abhijay-py/custom-keypad/KiCAD Files/3D Models/asm_mx_asm_PCB.stp

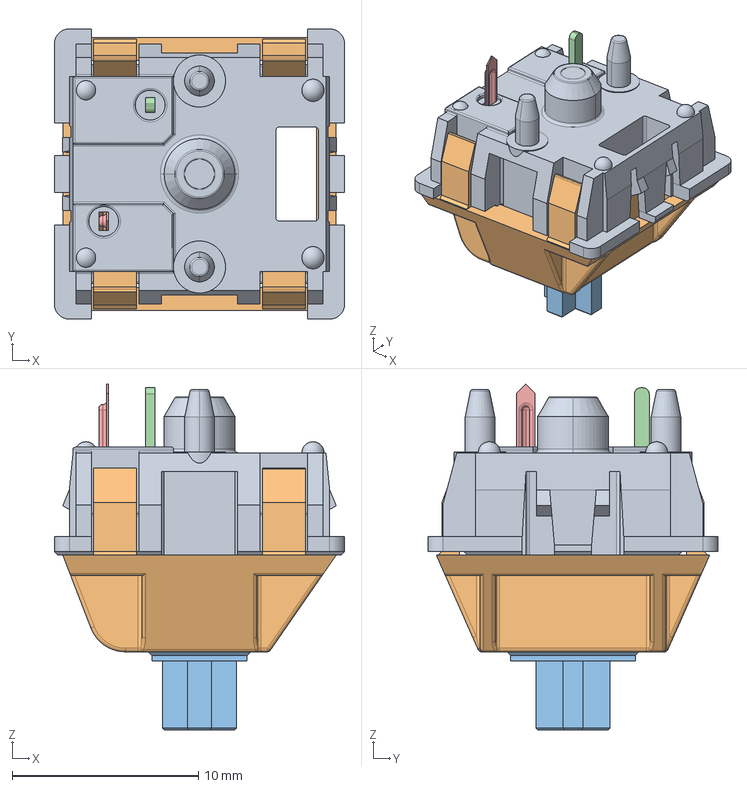
[picture p2: CAD file, 2025-04-11]
KiCAD Files/3D Models/asm_mx_asm_PCB.stp
15.6 x 15.6 x 18.6 mm
MX_DOWN
MX_UP
UP_MX
MX_PIN
MX_SPRING
MX_CLICK
