abhijay-py/custom-keypad/KiCAD Files/3D Models/EN11-HSM1BF20.stp

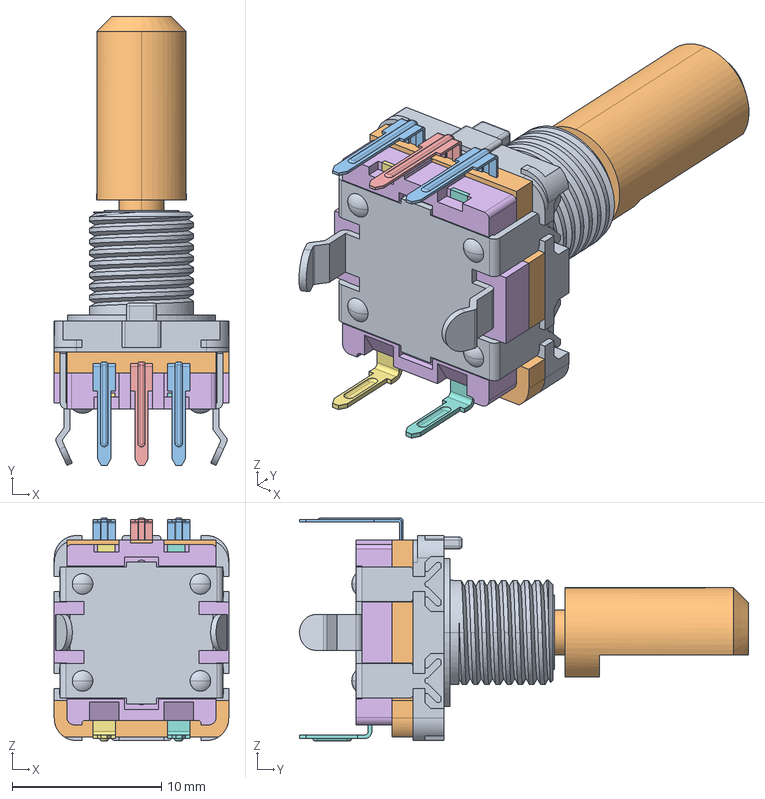
[picture p3: CAD file, 2025-04-14]
KiCAD Files/3D Models/EN11-HSM1BF20.stp
11.7 x 30.1 x 14.9 mm
