abhijay-py/custom-keypad/KiCAD Files/custom-keypad.step

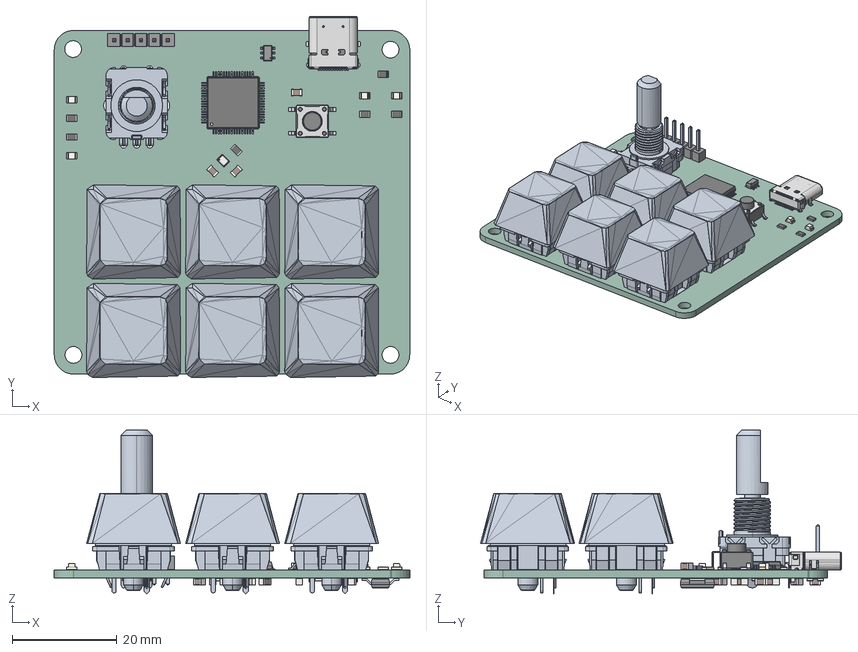
[picture p4: CAD file, 2025-07-17]
KiCAD Files/custom-keypad.step
67.8 x 68.9 x 31.3 mm
LED_0805_2012Metric x 4
R_0805_2012Metric x 10
ASM_MX_ASM x 6
product0 x 6
ASSEMBLY x 3
C_0805_2012Metric x 18
222AMVBAR
logo
dot
pins
F11ES7H20M_ASM
LQFP_64_10x10mm_P05mm
UJ32-C-H-G-H2-SMT-TR
custom-keypad_PCB
