abhijay-py/custom-keypad/Mechanical Case Files/case_bottom.stl

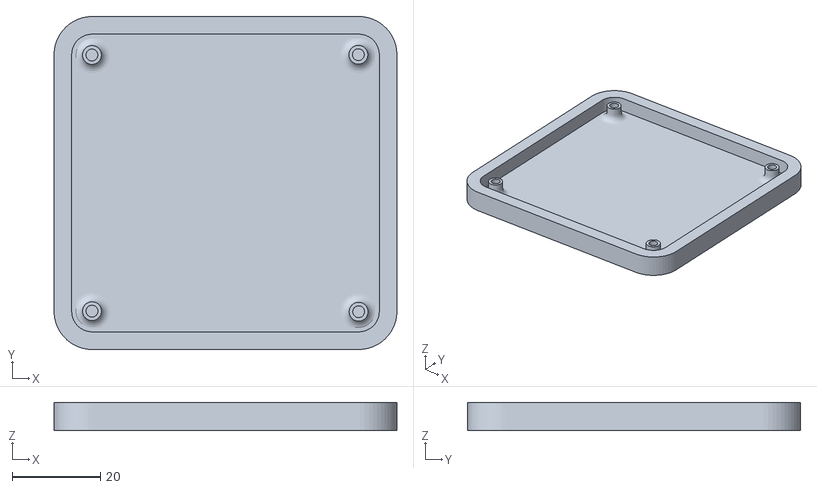
[picture p5: CAD file, 2025-07-17]
Mechanical Case Files/case_bottom.stl
77.8 x 75.6 x 6.40
