abhijay-py/custom-keypad/KiCAD Files/3D Models/XRCGB25M000FAN00R0.stp

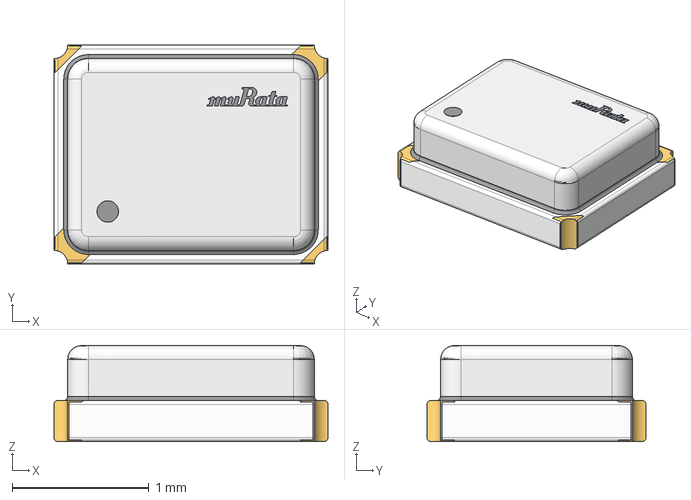
[picture p6: CAD file, 2025-04-12]
KiCAD Files/3D Models/XRCGB25M000FAN00R0.stp
2.00 x 1.60 x 0.702 mm
