abhijay-py/custom-keypad/Mechanical Case Files/case_top.stl

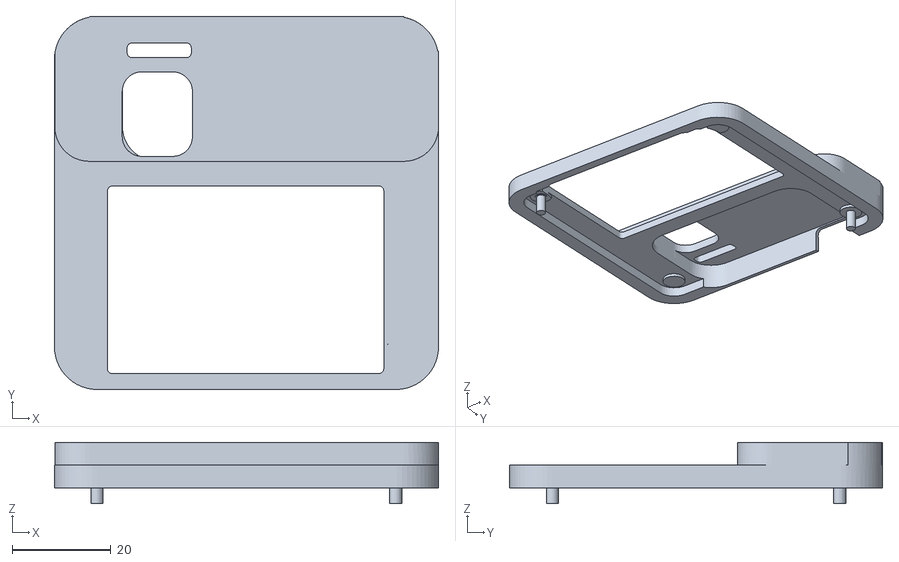
[picture p7: CAD file, 2025-07-17]
Mechanical Case Files/case_top.stl
77.8 x 75.6 x 12.5
