abhijay-py/custom-keypad/KiCAD Files/3D Models/ImageToStl.com_Simple-CherryMX-Keycap.stp

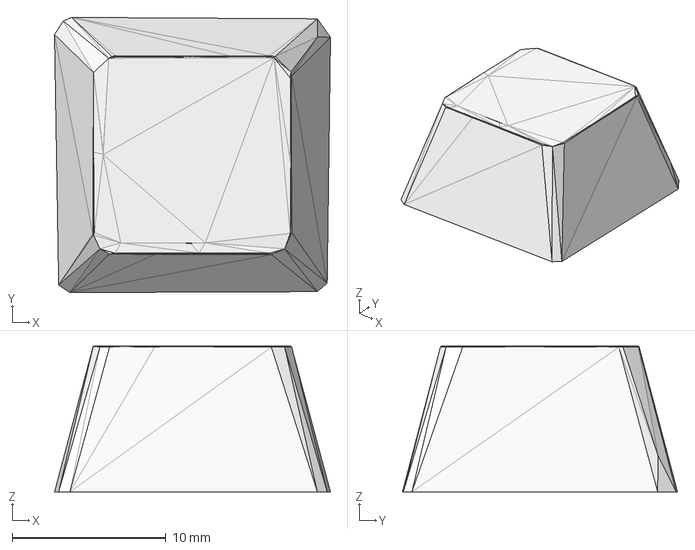
[picture p8: CAD file, 2025-04-11]
KiCAD Files/3D Models/ImageToStl.com_Simple-CherryMX-Keycap.stp
18.0 x 17.9 x 9.50 mm
