abhijay-py/custom-keypad/KiCAD Files/3D Models/UJ32-C-H-G-H2-SMT-TR.stp

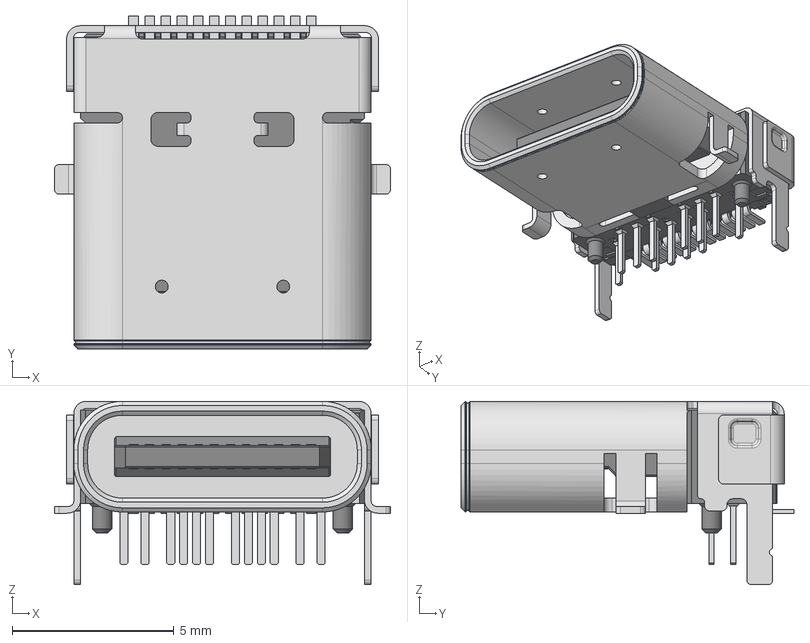
[picture p9: CAD file, 2025-04-11]
KiCAD Files/3D Models/UJ32-C-H-G-H2-SMT-TR.stp
10.4 x 10.3 x 5.67 mm
