abhijay-py/custom-keypad/KiCAD Files/3D Models/USBLC6-2SC6.stp

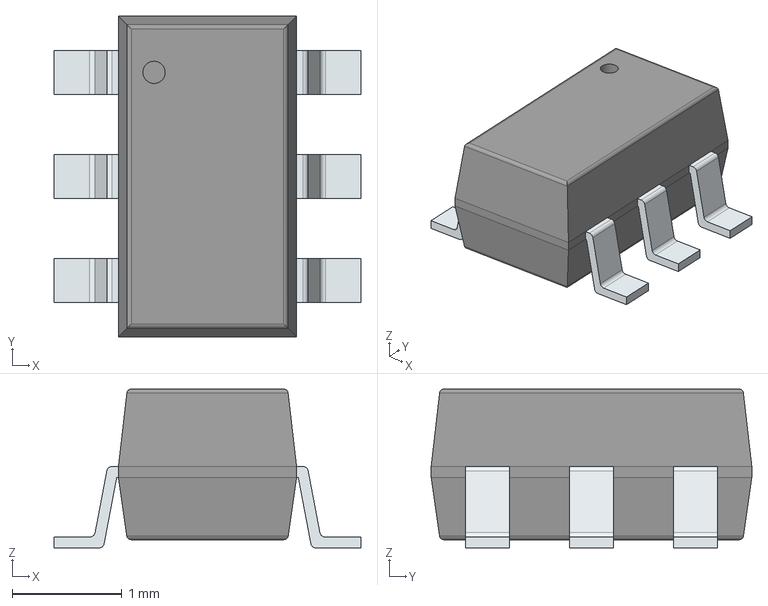
[picture p10: CAD file, 2025-04-11]
KiCAD Files/3D Models/USBLC6-2SC6.stp
2.80 x 2.92 x 1.45 mm
PinsArrayLR
