abhijay-py/custom-keypad/KiCAD Files/3D Models/LFXTAL010595.stp

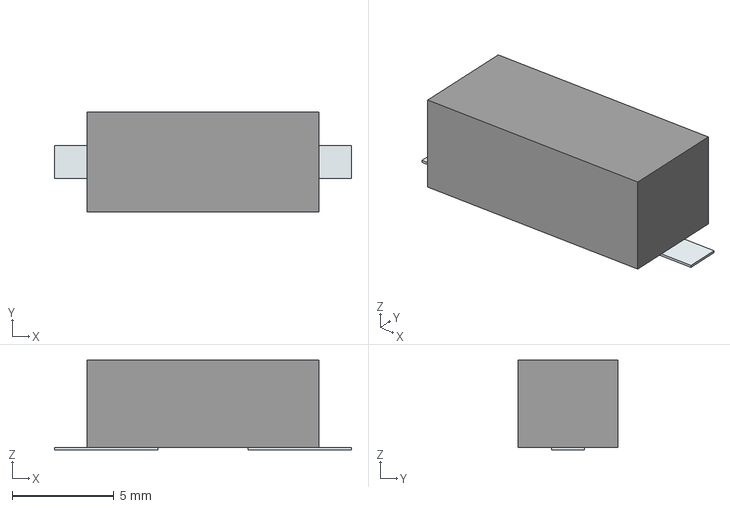
[picture p11: CAD file, 2025-04-11]
KiCAD Files/3D Models/LFXTAL010595.stp
14.6 x 4.90 x 4.40 mm
Pins
