abhijay-py/custom-keypad/KiCAD Files/3D Models/222AMVBAR.stp

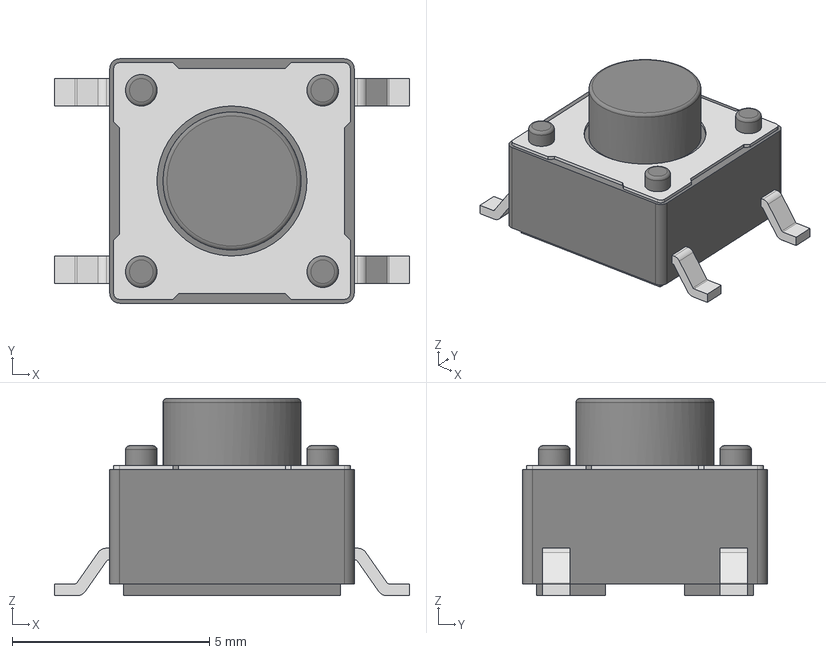
[picture p12: CAD file, 2025-04-11]
KiCAD Files/3D Models/222AMVBAR.stp
9.00 x 6.20 x 5.00 mm
