abhijay-py/custom-keypad/KiCAD Files/3D Models/AZ1117IH-3.3TRG1.stp

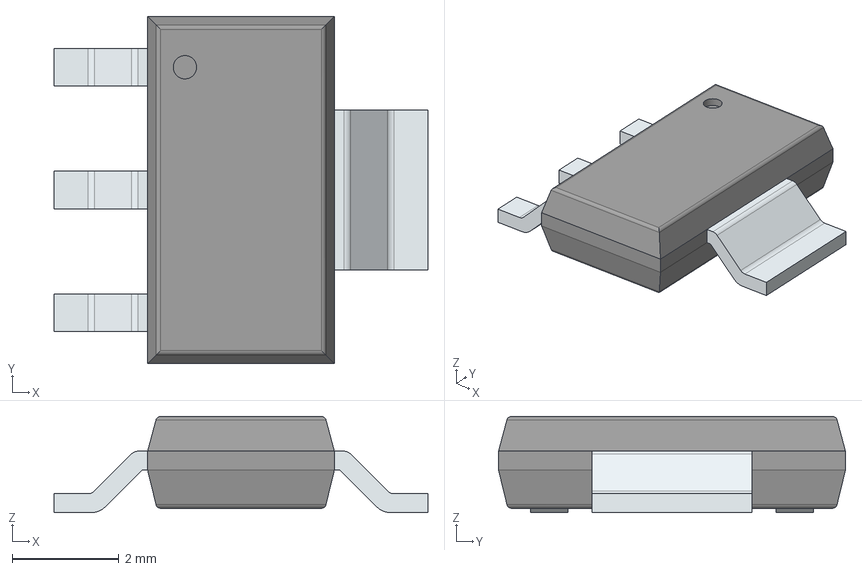
[picture p13: CAD file, 2025-04-11]
KiCAD Files/3D Models/AZ1117IH-3.3TRG1.stp
7.00 x 6.50 x 1.80 mm
PinsArrayL
FilletPinR
