abhijay-py/custom-keypad/KiCAD Files/3D Models/61300511121.stp

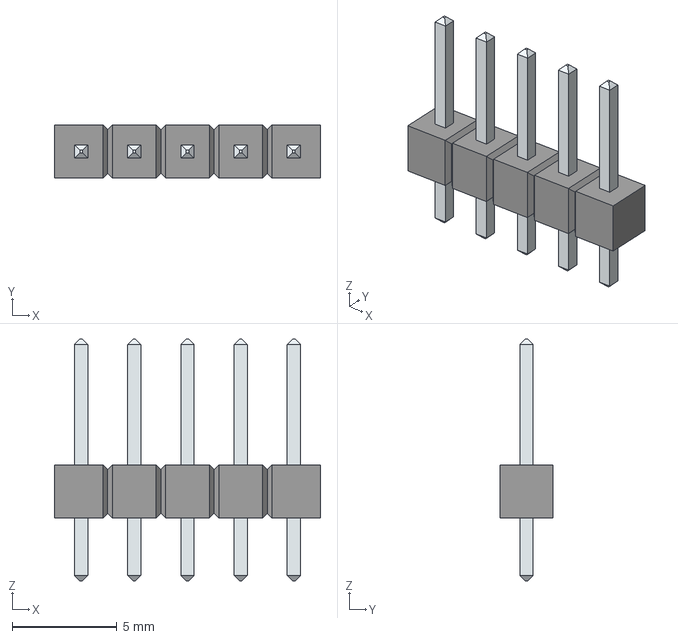
[picture p14: CAD file, 2025-04-11]
KiCAD Files/3D Models/61300511121.stp
12.7 x 2.54 x 11.5 mm
LeadsArray
