abhijay-py/custom-keypad/KiCAD Files/custom-keypad.kicad_pcb

## KiCad design KiCAD Files/custom-keypad.kicad_pcb (2025-04-23)

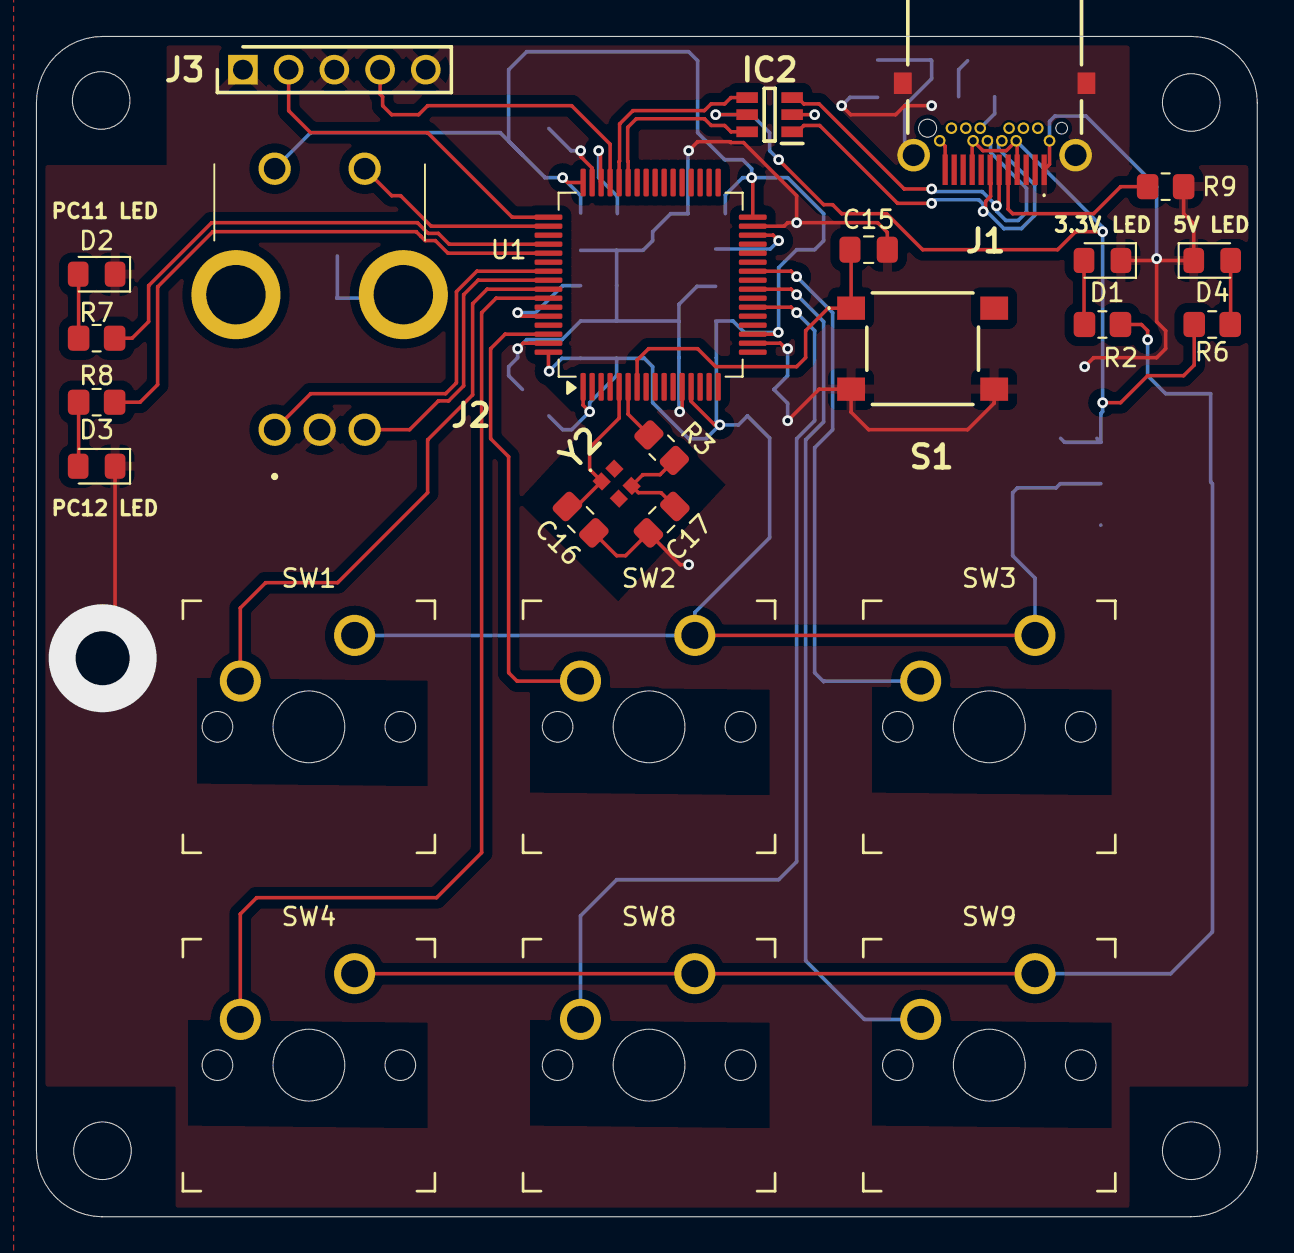
[picture p15: board custom-keypad.kicad_pcb from above]

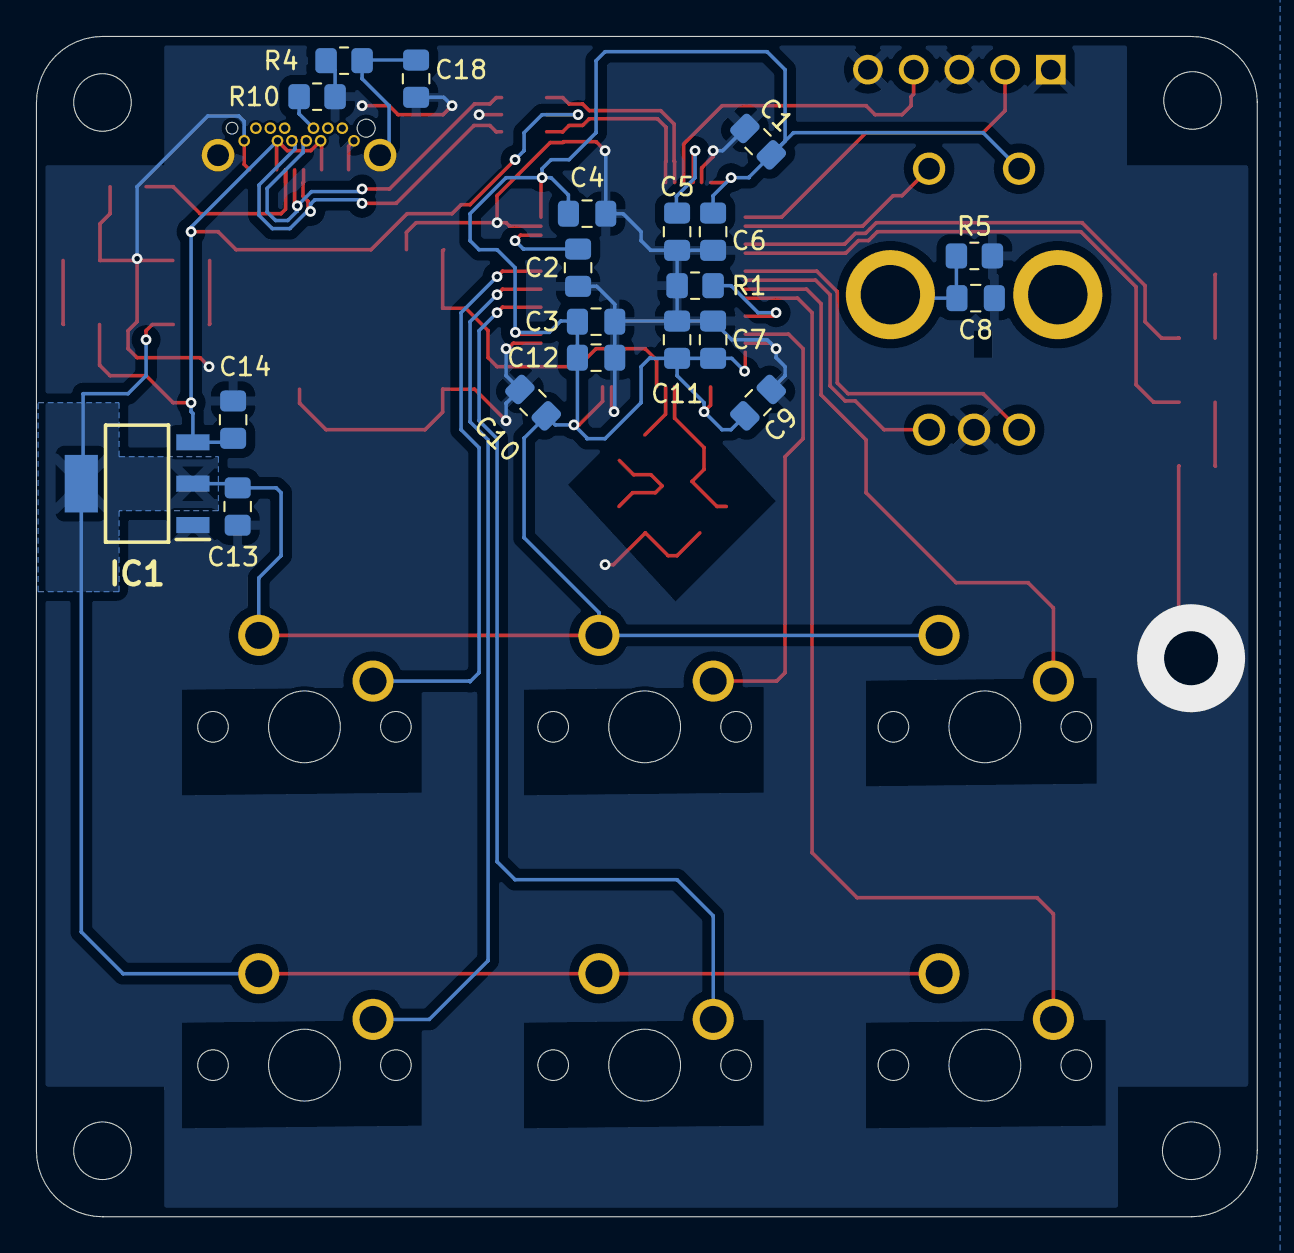
[picture p16: board custom-keypad.kicad_pcb from below]

Board: 2 copper layers, 67.8 x 65.6 mm, 46 parts (20 on the bottom side), 35 nets.

Parts:
C1: 4.7u; C_0805_2012Metric_Pad1.18x1.45mm_HandSolder
C2, C3, C4, C5, C6, C7, C11, C12: 100n; C_0805_2012Metric_Pad1.18x1.45mm_HandSolder
C8, C18: 2.2n; C_0805_2012Metric_Pad1.18x1.45mm_HandSolder
C9, C10: 1u; C_0805_2012Metric_Pad1.18x1.45mm_HandSolder
C13: 22u; C_0805_2012Metric_Pad1.18x1.45mm_HandSolder
C14: 10u; C_0805_2012Metric_Pad1.18x1.45mm_HandSolder
C15: 0.1u; C_0805_2012Metric_Pad1.18x1.45mm_HandSolder
C16, C17: 10p; C_0805_2012Metric_Pad1.18x1.45mm_HandSolder
D1, D2, D3, D4: LED; LED_0805_2012Metric_Pad1.15x1.40mm_HandSolder
IC1: AZ1117IH-3.3TRG1; SOT230P700X180-4N
IC2: USBLC6-2SC6; SOT95P280X145-6N
J1: UJ32-C-H-G-H2-SMT-TR; UJ32CHGH2SMTTR
J2: EN11-HSM1BF20; EN11HSM1BF20
J3: 61300511121; HDRV5W64P0X254_1X5_1270X254X854P
R1: 10k; R_0805_2012Metric_Pad1.20x1.40mm_HandSolder
R2, R7, R8: 220; R_0805_2012Metric_Pad1.20x1.40mm_HandSolder
R3, R6: 330; R_0805_2012Metric_Pad1.20x1.40mm_HandSolder
R4, R5: 1M; R_0805_2012Metric_Pad1.20x1.40mm_HandSolder
R9, R10: 5.1k; R_0805_2012Metric_Pad1.20x1.40mm_HandSolder
S1: 222AMVBAR
SW1, SW2, SW3, SW4, SW8, SW9: SW_Push; SW_MX
U1: STM32H7A3RGTx; LQFP-64_10x10mm_P0.5mm
Y2: XRCGB25M000FAN00R0; XRCGB

Connections:
+5V: C14.1, IC1.3 (INPUT), IC2.5 (VBUS), J1.A4 (VBUS_1), J1.A9 (VBUS_2), J1.B4 (VBUS_3), J1.B9 (VBUS_4), R6.1
D+: IC2.3 (I/O2_1), J1.A6 (DP1), J1.B6 (DP2)
D-: IC2.1 (I/O1_1), J1.A7 (DN1), J1.B7 (DN2)
GND: C1.2, C2.2, C3.2, C4.2, C5.2, C6.2, C7.2, C8.2, C9.2, C10.2, C11.2, C12.2, C13.2, C14.2, C15.2, C16.2, C17.2, C18.2, D1.1 (K), D2.1 (K), D3.1 (K), D4.1 (K), IC1.1 (ADJ/GND), IC2.2 (GND), J1.A1 (GND_1), J1.A12 (GND_2), J1.B1 (GND_3), J1.B12 (GND_4), J2.C1, J3.1, J3.3, J3.5, R1.2, R4.2, R5.2, R9.2, R10.2, S1.2 (NO_1), S1.4 (NO_2), U1.12 (VSSA), U1.18 (VSS), U1.31 (VSS), U1.47 (VSS), U1.63 (VSS)
unnamed: C8.1, J2.MH2, R5.1
unnamed: C18.1, J1.MH2, R4.1
unnamed: D1.2 (A), R2.2
unnamed: D2.2 (A), R7.2
unnamed: D3.2 (A), R8.2
unnamed: D4.2 (A), R6.2
unnamed: J1.A5 (CC1), R9.1
unnamed: J1.B5 (CC2), R10.1
unnamed: R1.1, U1.60 (BOOT0)
unnamed: C17.1, R3.1, Y2.3 (XTAL_2)
PA6/Key 5: SW8.2, U1.22 (PA6)
PA13/SWDIO: J3.4, U1.45 (PA13)
PA14/SWCLK: J3.2, U1.49 (PA14)
PA15/Rotary SW: J2.E1, U1.50 (PA15)
PB0/Key 3: SW3.2, U1.26 (PB0)
PB3/Rotary A: J2.A1, U1.55 (PB3)
PB4/Rotary B: J2.B1, U1.56 (PB4)
PB5/Key 1: SW1.2, U1.57 (PB5)
PB6/Key 4: SW4.2, U1.58 (PB6)
PB9/Key 2: SW2.2, U1.62 (PB9)
PC4/Key 6: SW9.2, U1.24 (PC4)
PC11/Debug PC11: R7.1, U1.52 (PC11)
PC12/Debug PC12: R8.1, U1.53 (PC12)
PH0/OSC IN: C16.1, U1.5 (PH0), Y2.1 (XTAL_1)
PH1/OSC OUT: R3.2, U1.6 (PH1)
USB+: IC2.4 (I/O2_2), U1.44 (PA12)
USB-: IC2.6 (I/O1_2), U1.43 (PA11)
VBAT: C1.1, C3.1, C4.1, C6.1, C7.1, C9.1, C10.1, C11.1, C12.1, C13.1, IC1.2 (OUTPUT), IC1.4 (VOUT), J2.D1, R2.1, SW1.1, SW2.1, SW3.1, SW4.1, SW8.1, SW9.1, U1.1 (VBAT), U1.13 (VDDA), U1.19 (VDD), U1.32 (VDD), U1.48 (VDD), U1.64 (VDD)
VCAP1: C2.1, U1.30 (VCAP)
VCAP2: C5.1, U1.46 (VCAP)
nRST: C15.1, S1.1 (COM_1), U1.7 (NRST)
