abhijay-py/custom-keypad/CubeIDE Files/custom_keypad.ioc

Mcu.UserName=STM32H7A3RGTx
PA11.Signal=USB_OTG_HS_DM
PA12.Signal=USB_OTG_HS_DP
PA13.Signal=DEBUG_JTMS-SWDIO
PA14.Signal=DEBUG_JTCK-SWCLK
PA15.Signal=GPIO_Input
PA6.Signal=GPIO_Input
PB0.Signal=GPIO_Input
PB3.Signal=GPXTI3
PB4.Signal=GPXTI4
PB5.Signal=GPIO_Input
PB6.Signal=GPIO_Input
PB9.Signal=GPIO_Input
PC11.Signal=GPIO_Output
PC12.Signal=GPIO_Output
PC4.Signal=GPIO_Input
PH0-OSC_IN.Signal=RCC_OSC_IN
PH1-OSC_OUT.Signal=RCC_OSC_OUT
