abhijay-py/custom-keypad/(commit log)

2025-04-11 initial schematic files
    [222AMVBAR.stp, 61300511121.stp, AZ1117IH-3.3TRG1.stp, LFXTAL010595.stp, UJ32-C-H-G-H2-SMT-TR.stp, USBLC6-2SC6.stp, microcontroller.kicad_sch, morse-code-keyboard.kicad_pcb]
2025-04-11 changed out microcontroller
    Might add in a bit of debug circuitry + button leds will see tmmrw
    [microcontroller.kicad_sch, morse-code-keyboard.kicad_pcb, morse-code-keyboard.kicad_sch]
2025-04-11 initial schematic and pcb designs
    [EN11-HSM1BF20.stp, custom-keypad.kicad_pcb, custom-keypad.kicad_sch, morse-code-keyboard.kicad_pcb]
2025-04-11 improved PCB design and added debugging circuitry
    [ImageToStl.com_Simple-CherryMX-Keycap.stp, asm_mx_asm_PCB.stp, asm_mx_asm_PLATE.stp, custom-keypad.kicad_pcb, microcontroller.kicad_sch]
2025-04-11 fixed some drc issues and updated pcb
    [custom-keypad.kicad_pcb]
2025-04-11 adjusted placement of oscillator
    [custom-keypad.kicad_pcb]
2025-04-12 finished pcb and diagram, need to double check before producing
    [XRCGB25M000FAN00R0.stp, custom-keypad.kicad_pcb, custom-keypad.kicad_sch, microcontroller.kicad_sch]
2025-04-12 committing unsaved changes
    [custom-keypad.kicad_pcb]
2025-04-12 tweaked PCB to isolate USB a bit more
    [custom-keypad.kicad_pcb]
2025-04-14 tweaked 3d model + added drill files for jlc
    [EN11-HSM1BF20.stp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]
2025-04-15 initialized keyboard + added keyboard constants
    need to check what kind of timer system needs to be implemented to ensure volume status + all 6 keys can be communicated in parallel or close to parallel
    [custom-keypad.kicad_pcb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]
2025-04-15 updated kicad file status
2025-04-22 Started working on firmware, ran into issues with USB
    [custom_keypad.ioc, main.c, main.h]
2025-04-23 updated files for remaking pcb assembly
    [custom-keypad-B_Cu.gbl, custom-keypad-B_Mask.gbs, custom-keypad-B_Paste.gbp, custom-keypad-B_Silkscreen.gbo, custom-keypad-Edge_Cuts.gm1, custom-keypad-F_Cu.gtl, custom-keypad-F_Mask.gts, custom-keypad-F_Paste.gtp]
2025-06-01 adjusted programming header location to provide more space to dial
    [custom-keypad.kicad_pcb]
2025-06-01 closed kicad
2025-07-04 added psuedo-debouncing for play/skip/rewind buttons
    [main.c]
2025-07-05 retrieved older pcb files that were manufactured
    [custom-keypad.kicad_pcb, custom-keypad.step]
2025-07-09 got rotary encoder working, hotkey bugging
    figure out report system
    [custom_keypad.ioc, main.c]
2025-07-11 finalized case (adjustments can be made)
    [case_bottom.stl, case_top.stl]
2025-07-20 started adjusting changes for 65% keyboard
    [other_circuits.kicad_sch]
2025-07-20 Revert "started adjusting changes for 65% keyboard"
    This reverts commit 731512e8e337a2e6137dad3074b859df4f5567bd.
    [custom-keypad.kicad_sch, other_circuits.kicad_sch]
2025-07-20 updated with keyboard 65%
    [custom-keypad.kicad_sch, other_circuits.kicad_sch]
2025-08-14 added image of device
2025-08-14 removed image of device as it exists in readme
